AnaClaraAmorim/BengalaEletronica/Imagens/foto_bengala.JPG

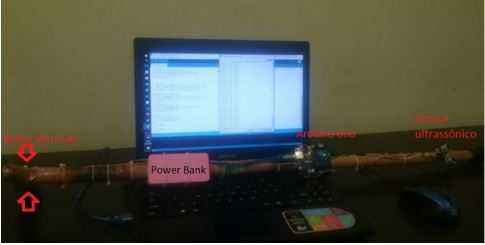
Imagens/foto_bengala.JPG
